blues27/ESP32_POV_LightStickV4/(commit log)

2022-09-13 Sample code
2022-10-03 [update] pxð0ɂ·éðð¢낢댟¢D
    pxðZbg·éû@ð͍õD
    VA͒x¢̂ÅTCPʐMðÀµ½D
